MatthewNik/Stormhacks-2026/working code/SSH_FIRMWARE_UPDATE.md

# USB firmware deployment through Pi SSH

Use [DEPLOY.md](DEPLOY.md) for the verified saved-version packages, full hardware update commands, and button-test restoration commands.
