MatthewNik/Stormhacks-2026/(list of files, cad)

Other CAD files:
tmp/servo-serial-test/serial_command_tests.obj
