MatthewNik/Stormhacks-2026/(commit log)

2026-10-03 commit 1
    [partitions.csv, serial_command_tests.obj]
2026-10-03 added tcrt5000 test code - works
    [partitions.csv]
2026-10-04 display working
    [partitions.csv]
2026-10-04 maintenance updates for servos
2026-10-04 Stop PCA faults during robot moves: stagger door commands, sample IR on a timer, retry PCA I2C
    Also includes the debounced IR capture that prevents false sensor-overflow pauses.
    [ConnectFourGameTest.ino, Esp32Sensors.h, GameConfig.h, PcaHardware.h, native_tests.cpp, pca_hardware_tests.cpp]
2026-10-04 Timed robot drop, lenient human IR with Centre-button resume, mirrored terminal board, PCA4 open 110
